JoseRenatoS/FechaduraEletronicaPIC18F4550/README.md

# Fechadura Eletrônica com Microcontrolador PIC18F4550

<p align="center">
  
</p>

## :round_pushpin: Índice 
* [:house: Descrição do Projeto](#house-descrição-do-projeto)
* [:computer: Tecnologias Utilizadas](#computer-tecnologias-utilizadas)
* [:link: Diagrama de Conexão](#link-diagrama-de-conexão)
* [:toolbox: Materiais & Custos](#toolbox-materiais--custos)
* [:memo: Licença](#memo-licença)
<br><br><br><br><br>

## :house: Descrição do Projeto
Este repositório contém o projeto de uma fechadura eletrônica utilizando o microcontrolador PIC18F4550, usado como requisito parcial para aprovação nas disciplinas: "Microcontroladores" e "Eletrônica Analógica" do Curso de Engenharia Elétrica.
O relatório do projeto (PIN - Relatório.pdf) inclui um esquema do circuito, o código-fonte e a explicação detalhada do funcionamento, e outras instruções como configuração e utilização da fechadura eletrônica.
<br>

<p align="center">
  
</p>
<p align="center">Figura 1: Protótipo Completo da Fechadura Eletrônica</p>
<br><br><br><br>

## :computer: Tecnologias Utilizadas

- **Linguagem C**: usada para a programação do microcontrolador.
- **MikroC PRO for PIC**: software utilizado para programar o microcontrolador PIC18F4550 em Linguagem C.
- **Proteus 8 Professional**: usado simular o protótipo.
- **PICKit 3**: utilizado para transferir o código para o microcontrolador PIC18F4550.
<br><br><br><br><br>

## :link: Diagrama de Conexão
<p align="center">
  
</p>
<p align="center">Figura 2: Diagrama do Prótotipo, desenvolvido no software Proteus 8</p>
<br><br><br><br><br>

## :toolbox: Materiais & Custos
| Componentes | Preço Unitário (R$) | Quantidade | Preço (R$) |
|---|:---:|:---:|:---:|
| PIC18F4550  | 100,00 | 1 | 100,00 |
| Display LCD 16x2 | 15,00 | 1 | 15,00 |
| Teclado Matricial 4x4 | 10,90 | 1 | 10,90 |
| Relé 4 Canais | 20,65 | 1 | 20,65 |
| Resistores 10kΩ | 0,18 | 5 | 0,93 |
| Resistores 1kΩ | 0,18 | 1 | 0,18 |
| Resistores 330kΩ | 0,18 | 1 | 0,18 |
| Resistores 220kΩ | 0,18 | 2 | 0,36 |
| Capacitores 22pF | 0,22 | 2 | 0,44 |
| Transistores BC547 | 0,62 | 3 | 1,86 |
| Potenciômetro 22kΩ | 3,50 | 1 | 3,50 |
| Cristal Oscilador 8MHz | 2,60 | 1 | 2,60 |
| Diodo | 0,30 | 1 | 0,30 |
| Diodo Zener | 0,83 | 1 | 0,83 |
| Botão | 0,46 | 1 | 0,46 |
| Protoboard 830 pinos | 12,90 | 1 | 12,90 |
| Fonte Bivolt 9V/1A | 11,52 | 1 | 11,52 |
| Fonte Ajustável para Protoboard | 8,12 | 1 | 8,12 |
| **TOTAL** ||| **R$ 190,73** |
<br>

> [!NOTE]
> *Os valores dos componentes são aproximados, eles podem sofrer alterações a depender de diversos fatores. Como, por exemplo: o local onde será comprado os componentes.*

<br><br><br><br><br>

## :memo: Licença
Este projeto está licenciado nos termos da [MIT License](https://github.com/JoseRenatoS/FechaduraEletronicaPIC18F4550/blob/main/LICENSE).
<br><br><br><br><br>
