JoseRenatoS/FechaduraEletronicaPIC18F4550/(list of files, drawings)

Other design files:
Fechadura.pdsprj
